RolandoBlanca/RatCar-ElegooV4/Stripboard2.jpg

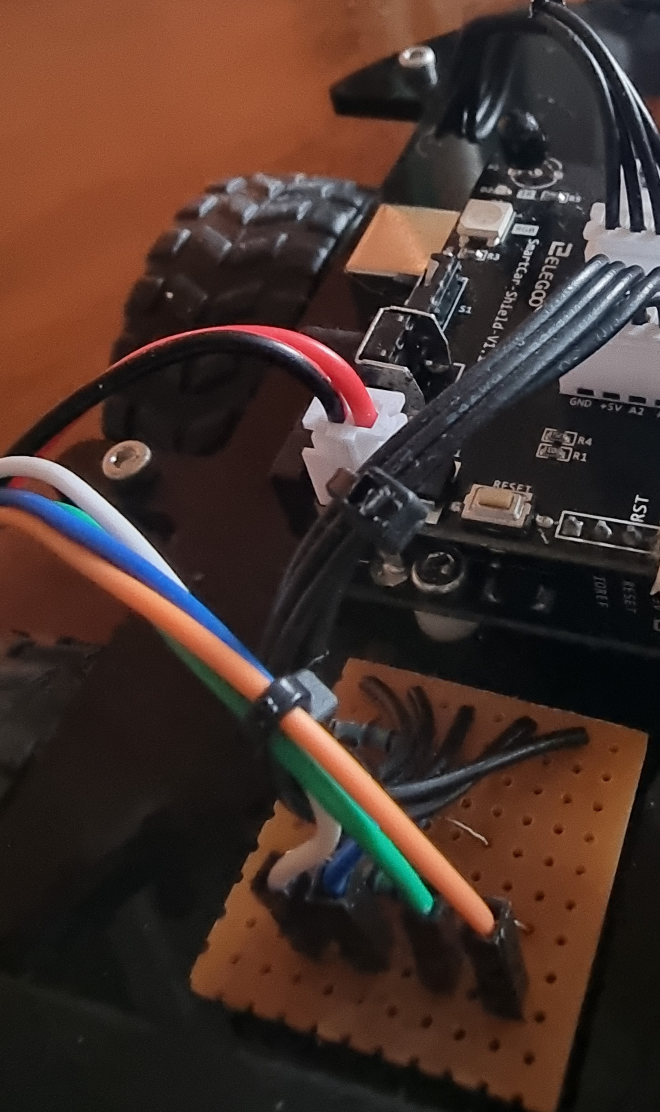
Stripboard2.jpg
