RolandoBlanca/RatCar-ElegooV4/Stripboard3.jpg

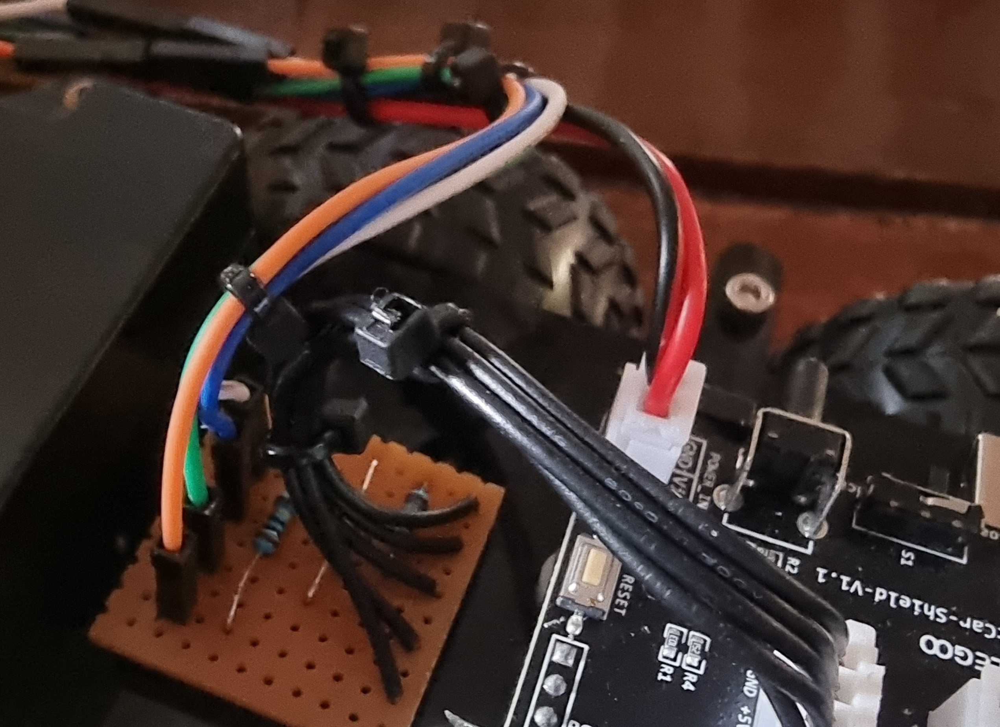
Stripboard3.jpg
