RolandoBlanca/RatCar-ElegooV4/LineTrackingHeader.jpg

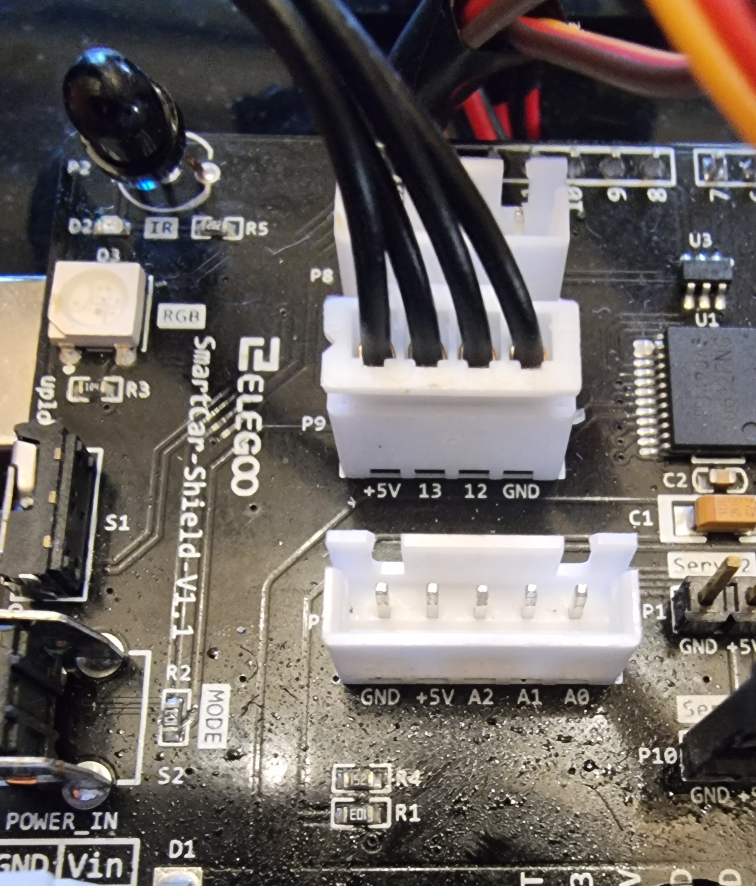
LineTrackingHeader.jpg
