RolandoBlanca/RatCar-ElegooV4/Rat Car Circuit diagram.png

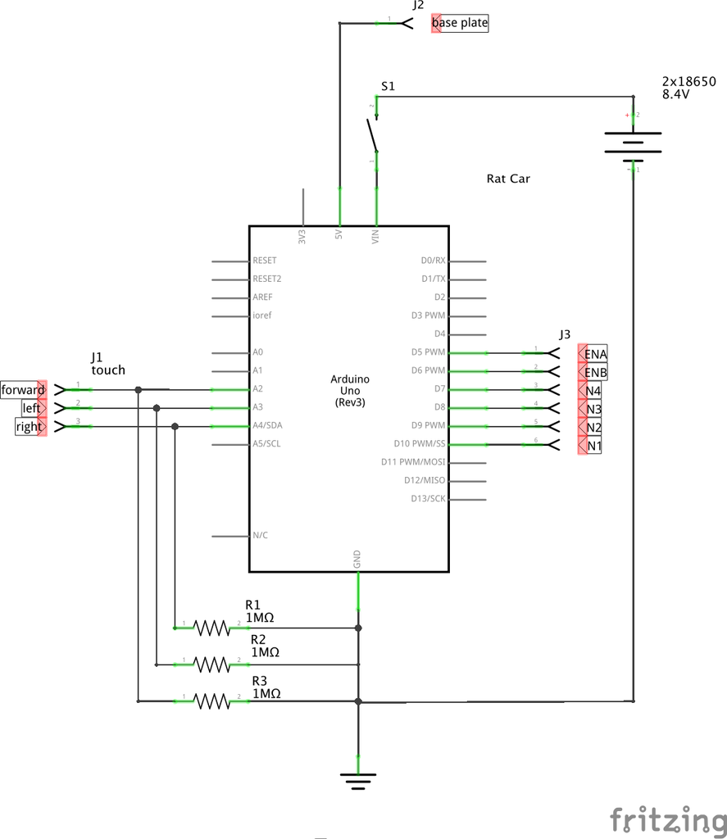
Rat Car Circuit diagram.png
