RolandoBlanca/RatCar-ElegooV4/Stripboard1.jpg

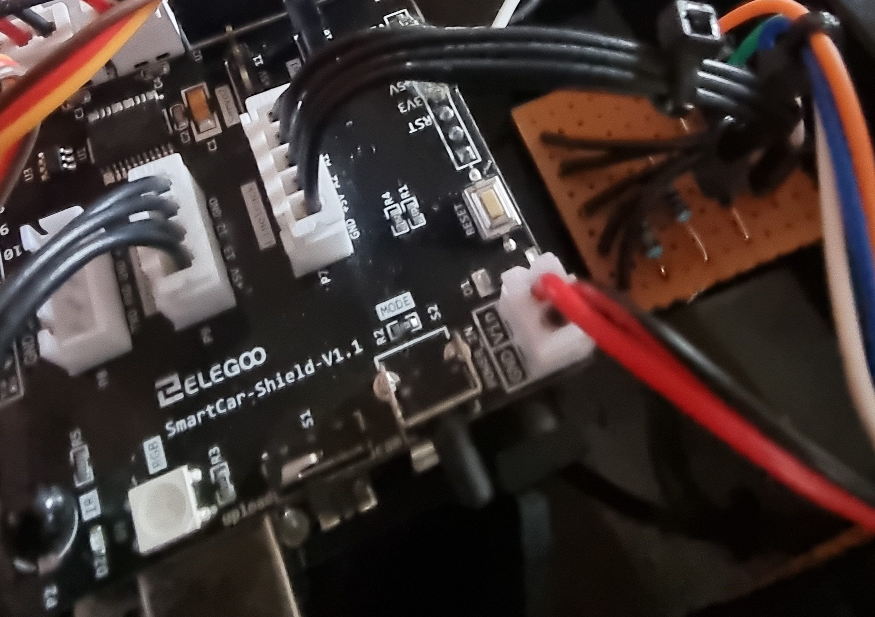
Stripboard1.jpg
